jamierowl13/bt-rotary-gsm-phone/(commit log)

2026-11-09 Add ESP32-S3 version with web interface
    ESP32-S3 + SIM900 sketch with rotary dial decoding, UK-cadence bell
    driven through a stepper driver or H-bridge, handset audio and a web
    page with a rotary dial and green/red call buttons.
    Claude-Session: https://claude.ai/code/session_01XqCRQ8ADrfRTb841ADk8fJ
2026-11-09 Fix 'ToneType was not declared' error in Arduino IDE
    The IDE inserts function prototypes above the first function, before
    the ToneType and CmdTag enums were declared. Move both enums to the
    top of the sketch.
    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
    [RotaryPhone.ino]
